h3llf/Arachnid_V2_RevB/ArachnidV2.kicad_sch

## KiCad design ArachnidV2.kicad_sch (2025-01-28)

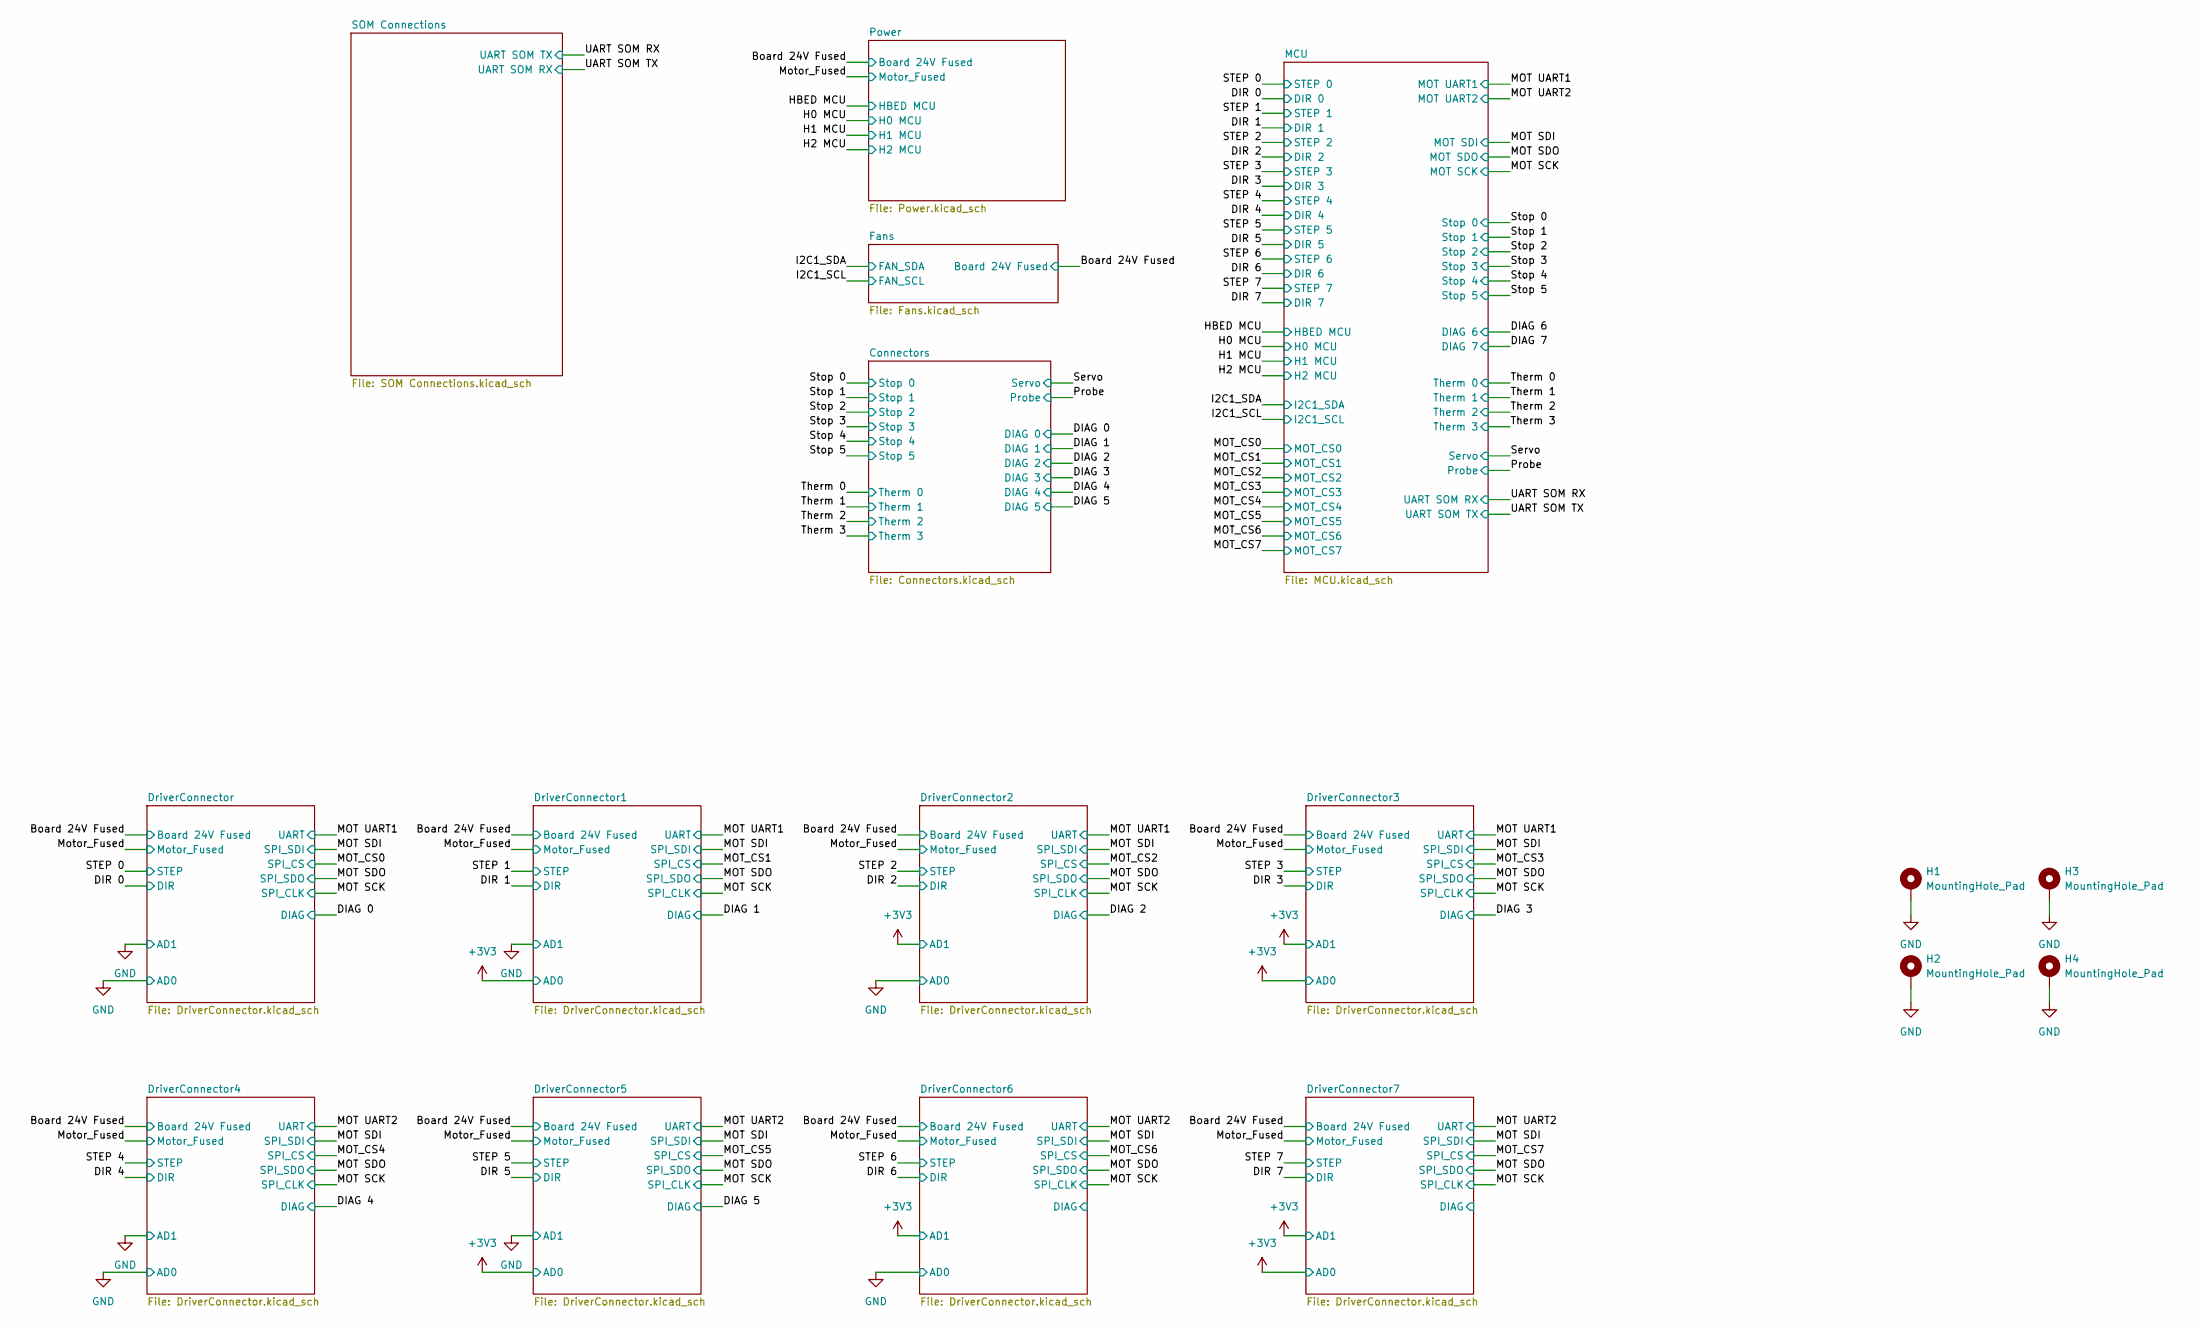
[picture p1: schematic ArachnidV2.kicad_sch]

Parts:
H1, H2, H3, H4: MountingHole_Pad; MountingHole_3.2mm_M3_Pad_TopBottom

Connections:
GND: H1.1, H2.1, H3.1, H4.1
