h3llf/Arachnid_V2_RevB/Connectors.kicad_sch

## KiCad design Connectors.kicad_sch (2025-01-28)

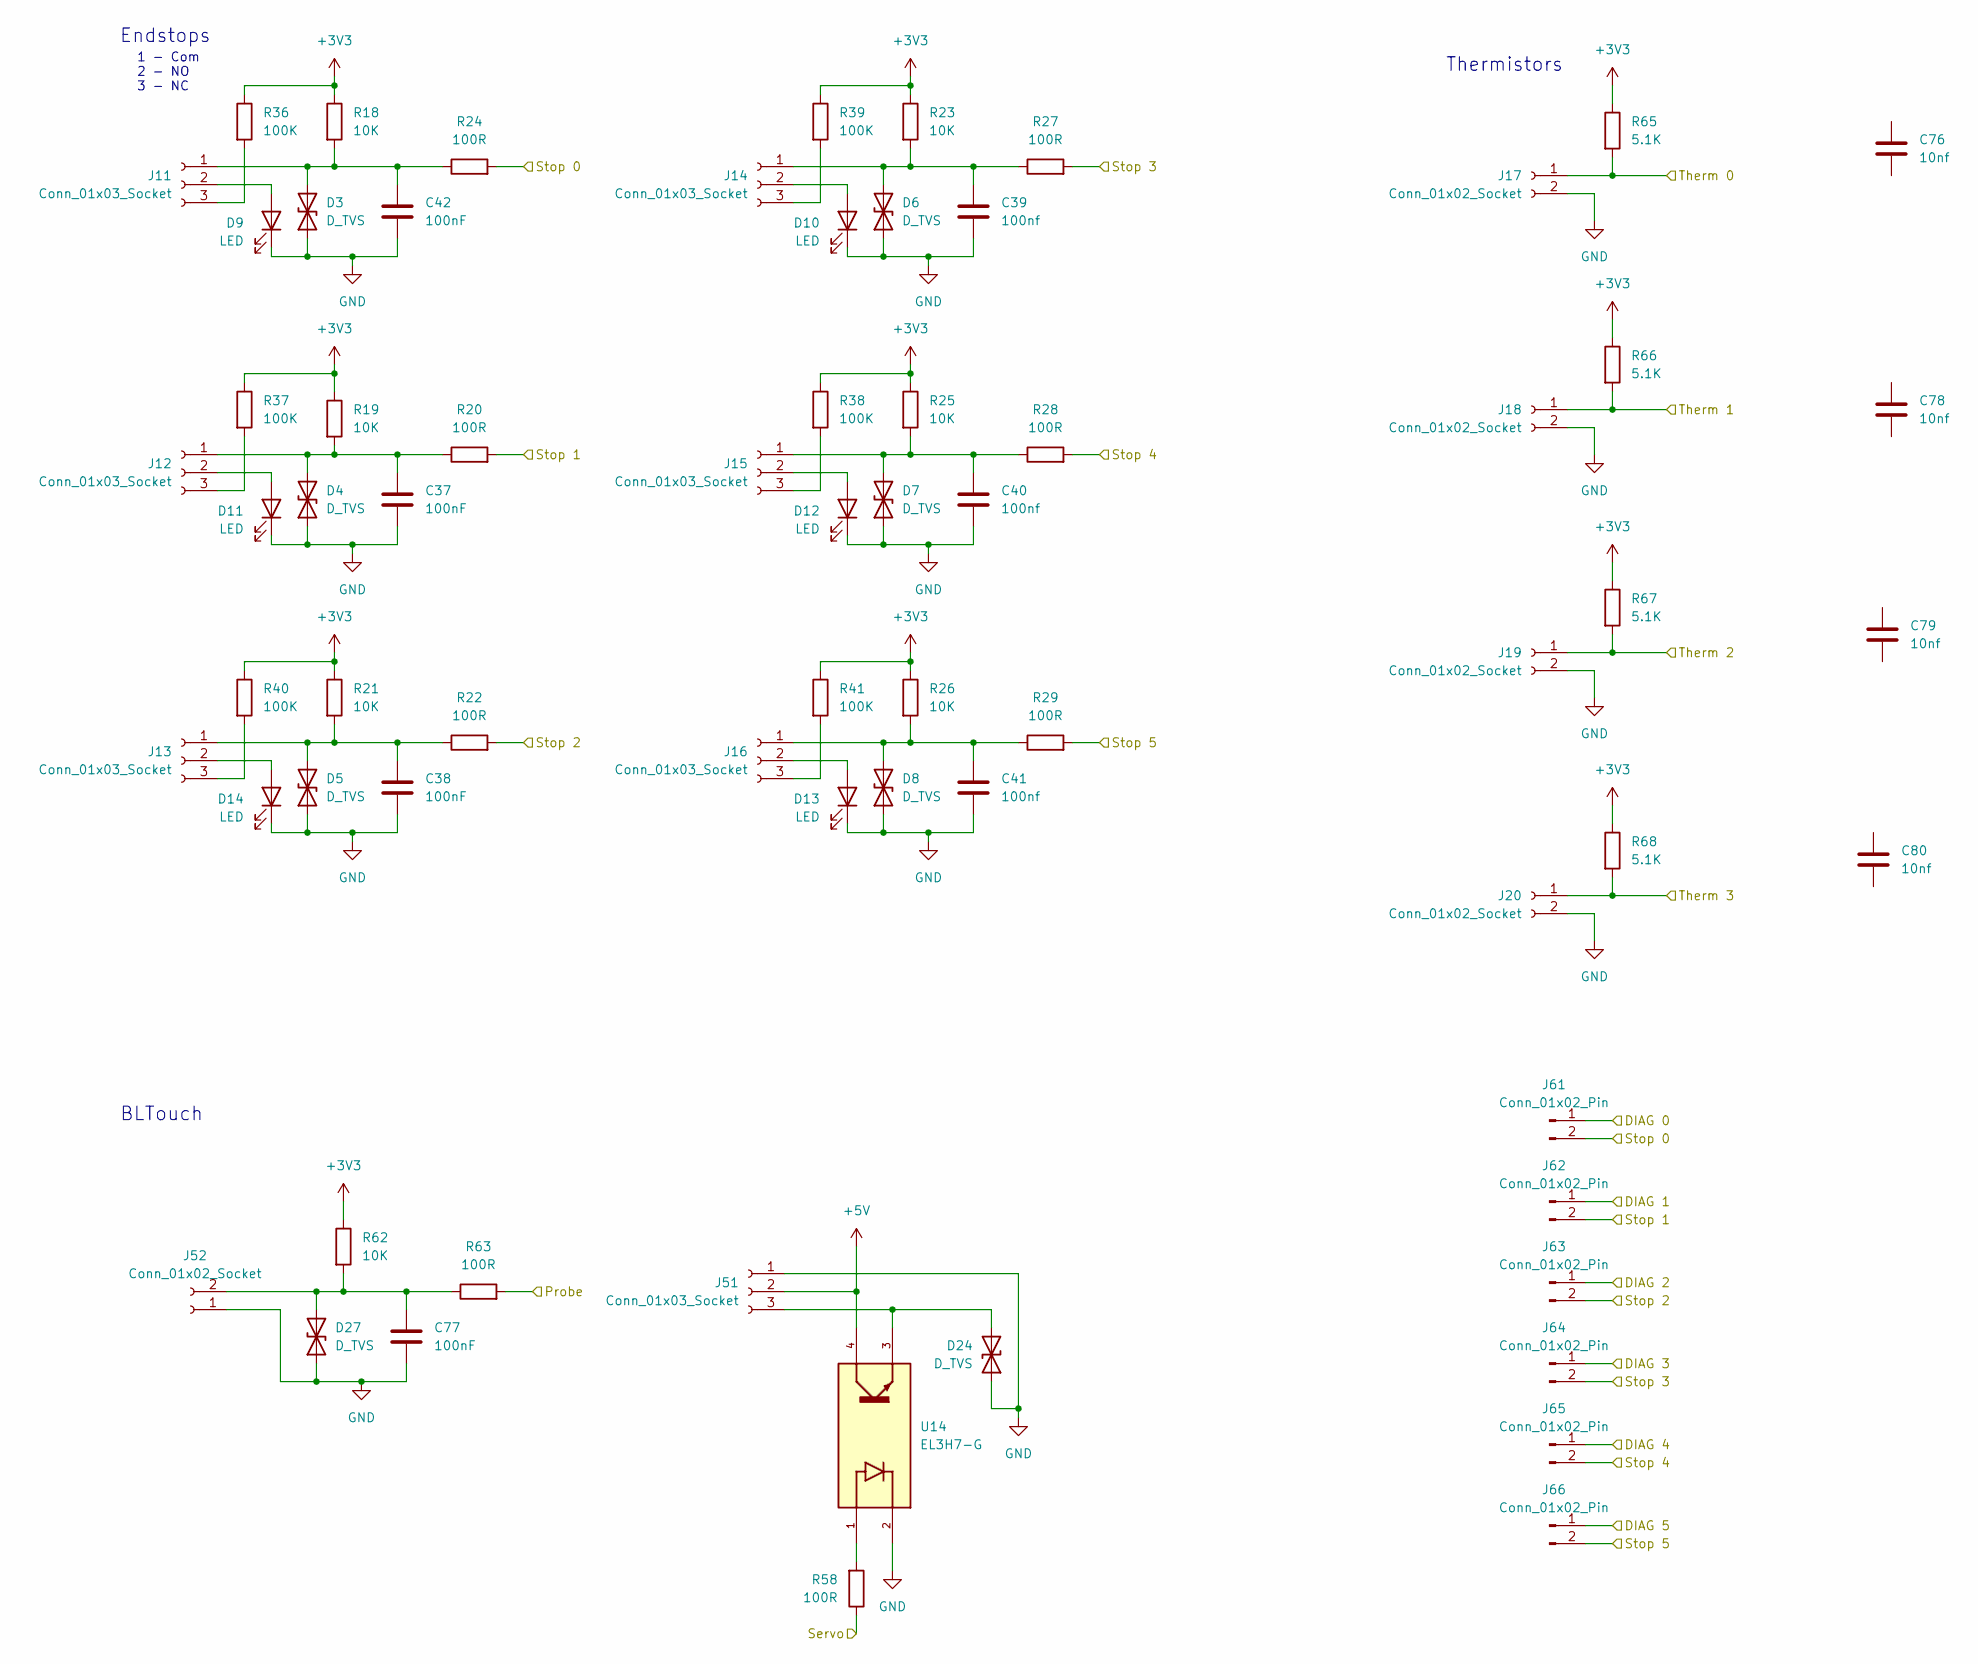
[picture p2: schematic Connectors.kicad_sch]

Parts:
C37, C38, C42, C77: 100nF; C_0603_1608Metric
C39, C40, C41: 100nf; C_0603_1608Metric
C76, C78, C79, C80: 10nf; C_0603_1608Metric
D3, D4, D5, D6, D7, D8, D27: D_TVS; D_SOD-882
D9, D10, D11, D12, D13, D14: LED; LED_0603_1608Metric
D24: D_TVS; D_SOD-323
J11, J12, J13, J14, J15, J16, J51: Conn_01x03_Socket; JST_XH_B3B-XH-A_1x03_P2.50mm_Vertical
J17, J18, J19, J20, J52: Conn_01x02_Socket; JST_XH_B2B-XH-A_1x02_P2.50mm_Vertical
J61, J62, J63, J64, J65, J66: Conn_01x02_Pin; PinHeader_1x02_P2.54mm_Vertical
R18, R19, R21, R23, R25, R26, R62: 10K; R_0603_1608Metric
R20, R22, R24, R27, R28, R29, R58, R63: 100R; R_0603_1608Metric
R36, R37, R38, R39, R40, R41: 100K; R_0603_1608Metric
R65, R66, R67, R68: 5.1K; R_0603_1608Metric
U14: EL3H7-G; SOIC127P700X200-4N; PARTREV 7

Connections:
+3V3: R18.1, R19.1, R21.1, R23.1, R25.1, R26.1, R36.1, R37.1, R38.1, R39.1, R40.1, R41.1, R62.1, R65.1, R66.1, R67.1, R68.1
+5V: J51.2, U14.4
DIAG 0: J61.1
DIAG 1: J62.1
DIAG 2: J63.1
DIAG 3: J64.1
DIAG 4: J65.1
DIAG 5: J66.1
GND: C37.2, C38.2, C39.2, C40.2, C41.2, C42.2, C77.2, D3.1 (A1), D4.1 (A1), D5.1 (A1), D6.1 (A1), D7.1 (A1), D8.1 (A1), D9.1 (K), D10.1 (K), D11.1 (K), D12.1 (K), D13.1 (K), D14.1 (K), D24.1 (A1), D27.1 (A1), J17.2, J18.2, J19.2, J20.2, J51.1, J52.1, U14.2
unnamed: C37.1, D4.2 (A2), J12.1, R19.2, R20.1
unnamed: C38.1, D5.2 (A2), J13.1, R21.2, R22.1
unnamed: C39.1, D6.2 (A2), J14.1, R23.2, R27.1
unnamed: C40.1, D7.2 (A2), J15.1, R25.2, R28.1
unnamed: C41.1, D8.2 (A2), J16.1, R26.2, R29.1
unnamed: C42.1, D3.2 (A2), J11.1, R18.2, R24.1
unnamed: C77.1, D27.2 (A2), J52.2, R62.2, R63.1
unnamed: D9.2 (A), J11.2
unnamed: D10.2 (A), J14.2
unnamed: D11.2 (A), J12.2
unnamed: D12.2 (A), J15.2
unnamed: D13.2 (A), J16.2
unnamed: D14.2 (A), J13.2
unnamed: D24.2 (A2), J51.3, U14.3
unnamed: J11.3, R36.2
unnamed: J12.3, R37.2
unnamed: J13.3, R40.2
unnamed: J14.3, R39.2
unnamed: J15.3, R38.2
unnamed: J16.3, R41.2
unnamed: R58.2, U14.1
Probe: R63.2
Servo: R58.1
Stop 0: J61.2, R24.2
Stop 1: J62.2, R20.2
Stop 2: J63.2, R22.2
Stop 3: J64.2, R27.2
Stop 4: J65.2, R28.2
Stop 5: J66.2, R29.2
Therm 0: J17.1, R65.2
Therm 1: J18.1, R66.2
Therm 2: J19.1, R67.2
Therm 3: J20.1, R68.2

Notes on the sheet:
1 - Com 2 - NO 3 - NC
Endstops
BLTouch
Thermistors
