h3llf/Arachnid_V2_RevB/DriverConnector.kicad_sch

## KiCad design DriverConnector.kicad_sch (2025-01-28)

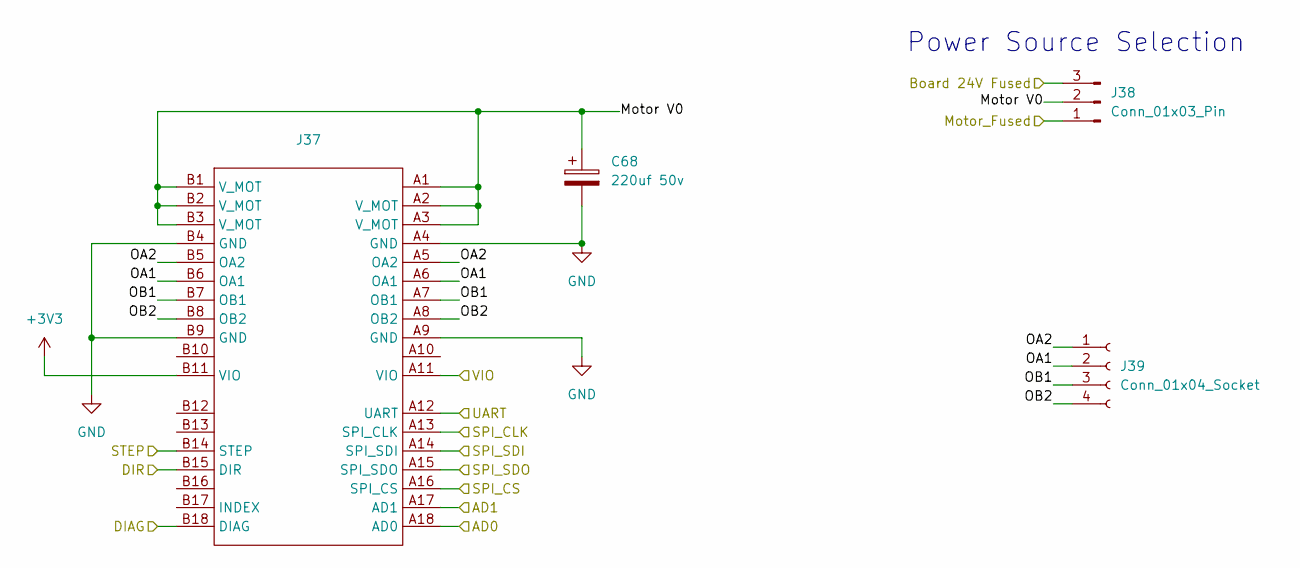
[picture p3: schematic DriverConnector.kicad_sch]

Parts:
C68: 220uf 50v; CP_Elec_10x10
J37: UMAX_3183-10200P1T_PCIEx1
J38: Conn_01x03_Pin; PinHeader_1x03_P2.54mm_Vertical
J39: Conn_01x04_Socket; JST_XH_B4B-XH-A_1x04_P2.50mm_Vertical

Connections:
+3V3: J37.B11 (VIO)
AD0: J37.A18 (AD0)
AD1: J37.A17 (AD1)
Board 24V Fused: J38.3
DIAG: J37.B18 (DIAG)
DIR: J37.B15 (DIR)
GND: C68.2, J37.A4 (GND), J37.A9 (GND), J37.B4 (GND), J37.B9 (GND)
Motor V0: C68.1, J37.A1, J37.A2 (V_MOT), J37.A3 (V_MOT), J37.B1 (V_MOT), J37.B2 (V_MOT), J37.B3 (V_MOT), J38.2
Motor_Fused: J38.1
OA1: J37.A6 (OA1), J37.B6 (OA1), J39.2
OA2: J37.A5 (OA2), J37.B5 (OA2), J39.1
OB1: J37.A7 (OB1), J37.B7 (OB1), J39.3
OB2: J37.A8 (OB2), J37.B8 (OB2), J39.4
SPI_CLK: J37.A13 (SPI_CLK)
SPI_CS: J37.A16 (SPI_CS)
SPI_SDI: J37.A14 (SPI_SDI)
SPI_SDO: J37.A15 (SPI_SDO)
STEP: J37.B14 (STEP)
UART: J37.A12 (UART)
VIO: J37.A11 (VIO)

Notes on the sheet:
Power Source Selection
