h3llf/Arachnid_V2_RevB/Fans.kicad_sch

## KiCad design Fans.kicad_sch (2025-01-28)

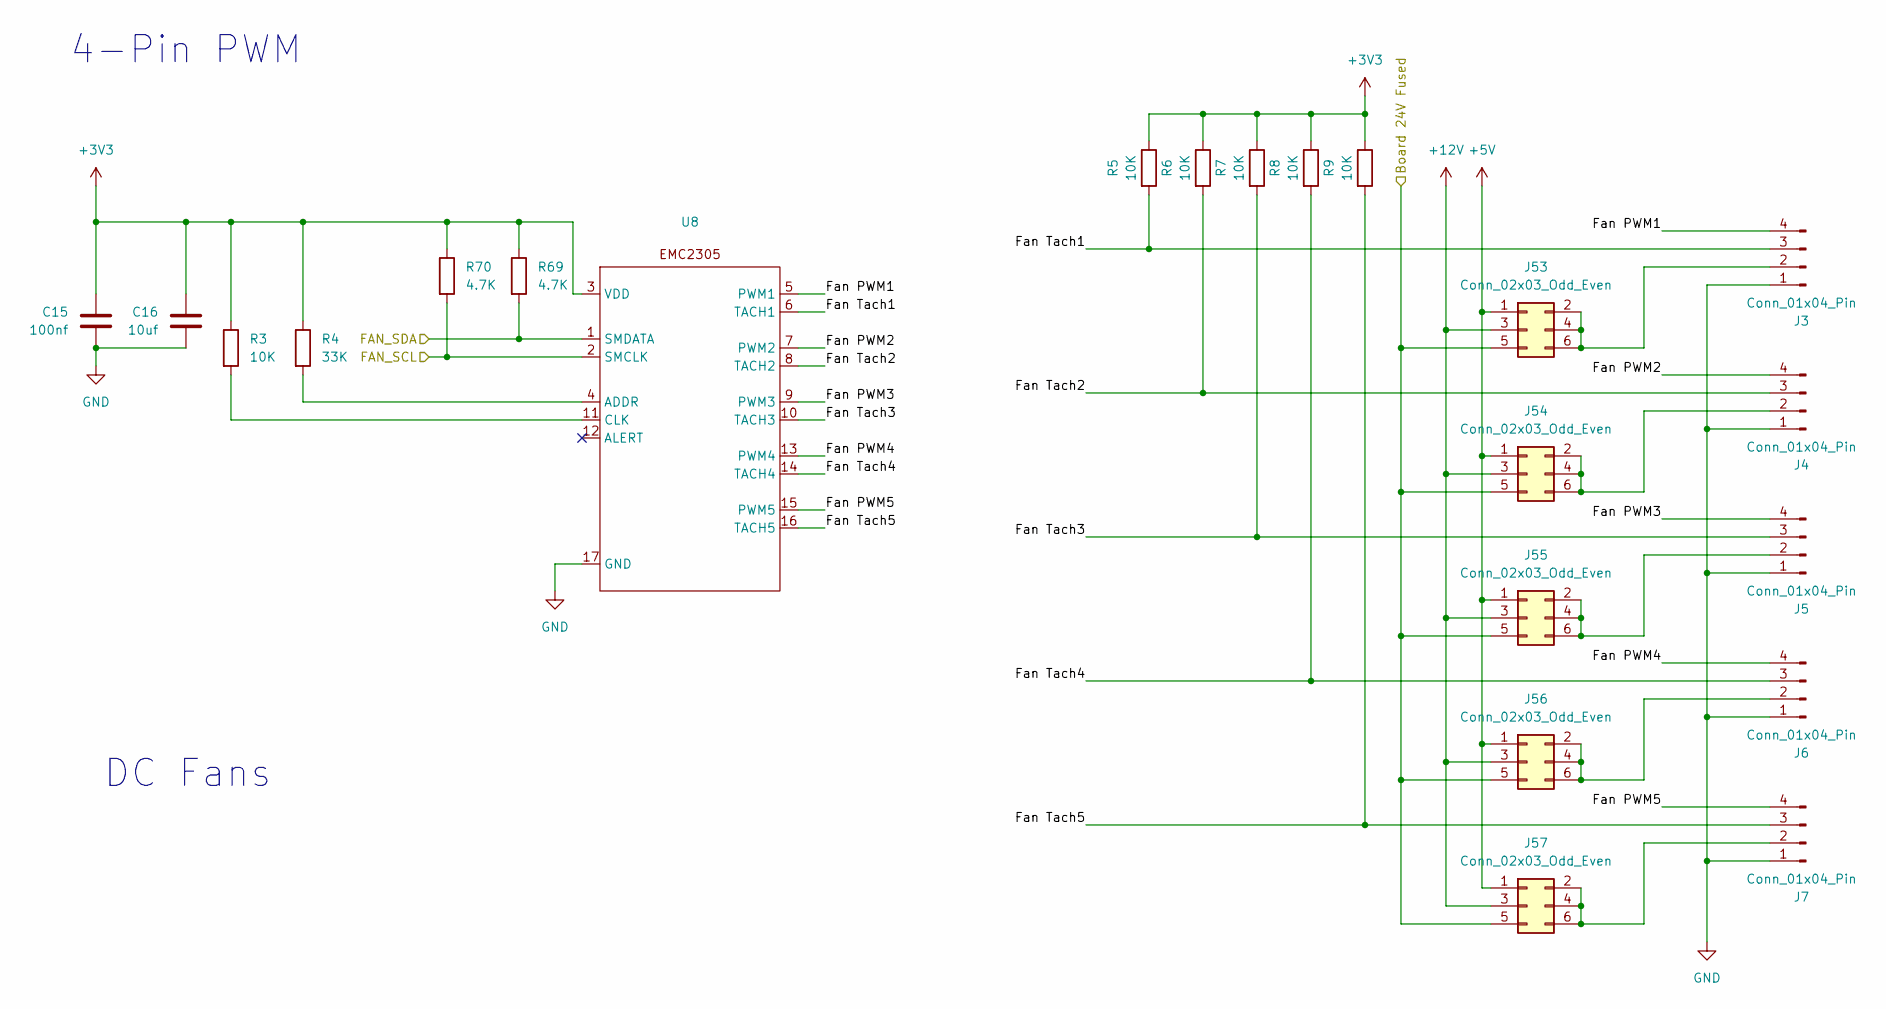
[picture p4: schematic Fans.kicad_sch]

Parts:
C15: 100nf; C_0603_1608Metric
C16: 10uf; C_0603_1608Metric
J3, J4, J5, J6, J7: Conn_01x04_Pin; FanPinHeader_1x04_P2.54mm_Vertical
J53, J54, J55, J56, J57: Conn_02x03_Odd_Even; PinHeader_2x03_P2.54mm_Vertical
R3: 10K; R_0603_1608Metric
R4: 33K; R_0603_1608Metric
R5, R6, R7, R8, R9: 10K; R_0402_1005Metric_Pad0.72x0.64mm_HandSolder
R69, R70: 4.7K; R_0603_1608Metric
U8: QFN-16-1EP_4x4mm_P0.65mm_EP2.1x2.1mm

Connections:
+3V3: C15.1, C16.1, R3.1, R4.1, R5.1, R6.1, R7.1, R8.1, R9.1, R69.1, R70.1, U8.3 (VDD)
+5V: J53.1, J54.1, J55.1, J56.1, J57.1
+12V: J53.3, J54.3, J55.3, J56.3, J57.3
Board 24V Fused: J53.5, J54.5, J55.5, J56.5, J57.5
FAN_SCL: R70.2, U8.2 (SMCLK)
FAN_SDA: R69.2, U8.1 (SMDATA)
Fan PWM1: J3.4, U8.5 (PWM1)
Fan PWM2: J4.4, U8.7 (PWM2)
Fan PWM3: J5.4, U8.9 (PWM3)
Fan PWM4: J6.4, U8.13 (PWM4)
Fan PWM5: J7.4, U8.15 (PWM5)
Fan Tach1: J3.3, R5.2, U8.6 (TACH1)
Fan Tach2: J4.3, R6.2, U8.8 (TACH2)
Fan Tach3: J5.3, R7.2, U8.10 (TACH3)
Fan Tach4: J6.3, R8.2, U8.14 (TACH4)
Fan Tach5: J7.3, R9.2, U8.16 (TACH5)
GND: C15.2, C16.2, J3.1, J4.1, J5.1, J6.1, J7.1, U8.17 (GND)
unnamed: J3.2, J53.2, J53.4, J53.6
unnamed: J4.2, J54.2, J54.4, J54.6
unnamed: J5.2, J55.2, J55.4, J55.6
unnamed: J6.2, J56.2, J56.4, J56.6
unnamed: J7.2, J57.2, J57.4, J57.6
unnamed: R3.2, U8.11 (CLK)
unnamed: R4.2, U8.4 (ADDR)

Notes on the sheet:
DC Fans
4-Pin PWM
