h3llf/Arachnid_V2_RevB/MCU.kicad_sch

## KiCad design MCU.kicad_sch (2025-01-28)

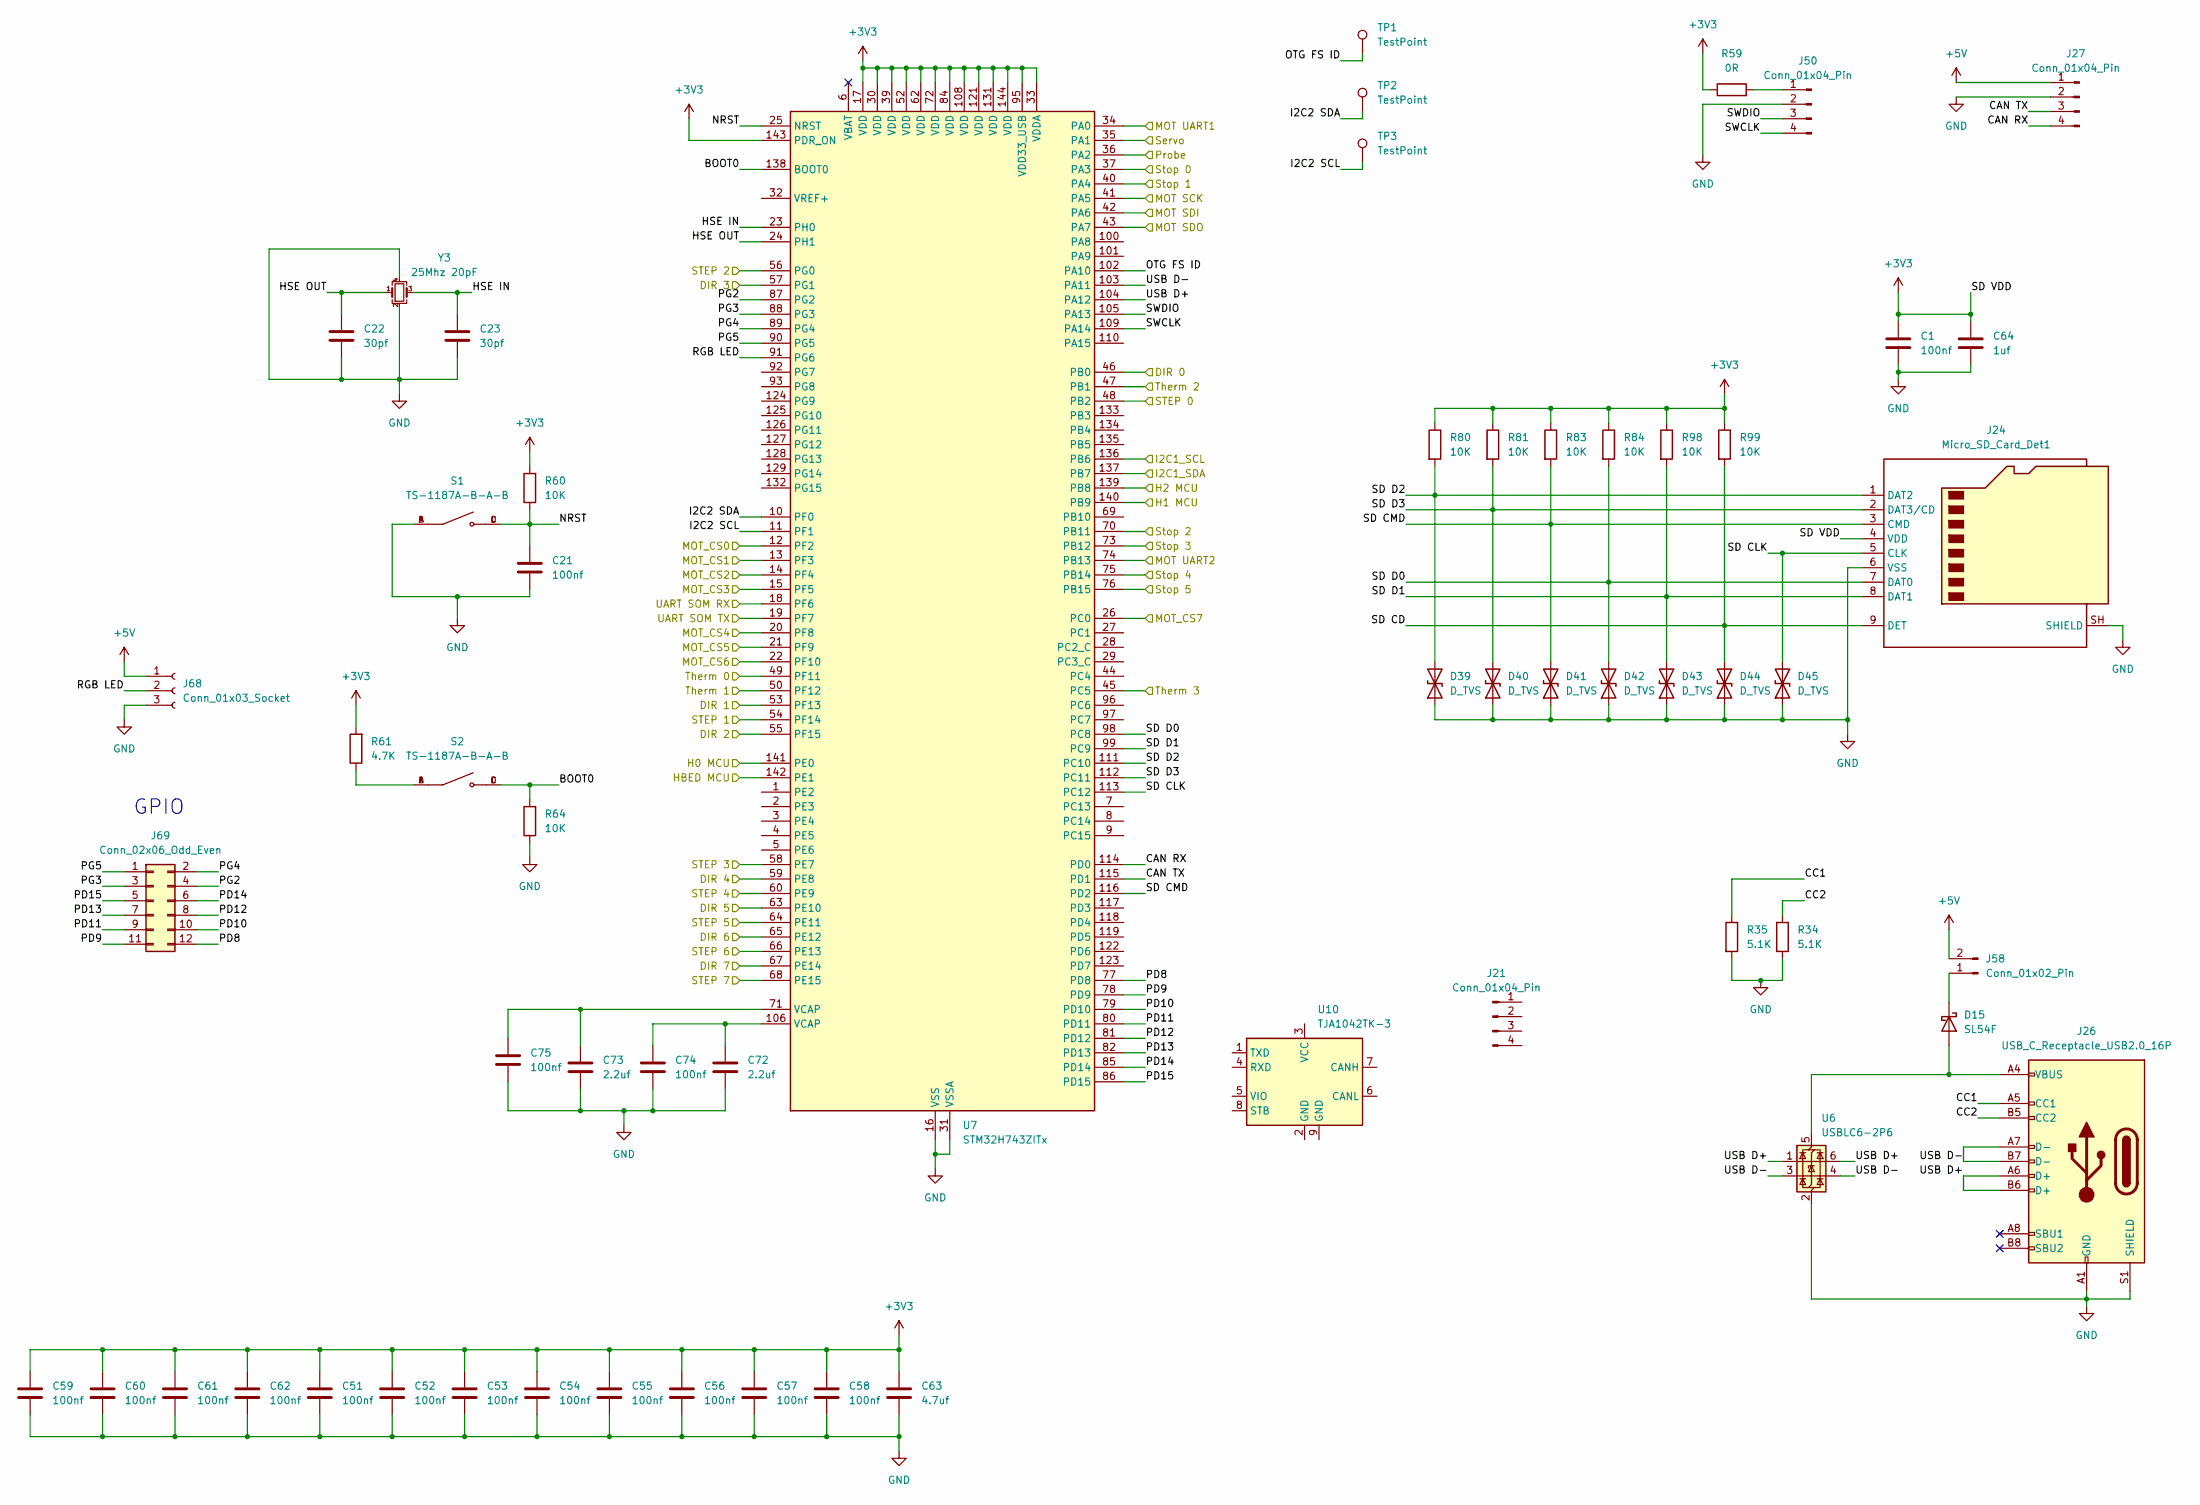
[picture p5: schematic MCU.kicad_sch]

Parts:
C1: 100nf; C_0402_1005Metric
C21, C51, C52, C53, C54, C55, C56, C57, C58, C59, C60, C61, C62, C74, C75: 100nf; C_0603_1608Metric
C22, C23: 30pf; C_0402_1005Metric
C63: 4.7uf; C_0603_1608Metric
C64: 1uf; C_0603_1608Metric
C72, C73: 2.2uf; C_0603_1608Metric
D15: SL54F; D_SMA; LCSC C113939
D39, D40, D41, D42, D43, D44, D45: D_TVS; D_SOD-882
J21: Conn_01x04_Pin; XT30_2+2
J24: Micro_SD_Card_Det1; TF-115
J26: USB_C_Receptacle_USB2.0_16P; USB-C-SMD_TYPE-C-31-M-31
J27, J50: Conn_01x04_Pin; PinHeader_1x04_P2.54mm_Vertical
J58: Conn_01x02_Pin; PinHeader_1x02_P2.54mm_Vertical
J68: Conn_01x03_Socket; PinHeader_1x03_P2.54mm_Vertical
J69: Conn_02x06_Odd_Even; PinHeader_2x06_P2.54mm_Vertical
R34, R35: 5.1K; R_0603_1608Metric
R59: 0R; R_0603_1608Metric
R60, R64: 10K; R_0603_1608Metric
R61: 4.7K; R_0603_1608Metric
R80, R81, R83, R84, R98, R99: 10K; R_0402_1005Metric
S1, S2: TS-1187A-B-A-B; SW_TS-1187A-B-A-B; PARTREV A0
TP1, TP2, TP3: TestPoint; TestPoint_Pad_1.5x1.5mm
U6: USBLC6-2P6; SOT-666
U7: STM32H743ZITx; LQFP-144_20x20mm_P0.5mm
U10: TJA1042TK-3; HVSON-8-1EP_3x3mm_P0.65mm_EP1.6x2.4mm
Y3: 25Mhz 20pF; Crystal_SMD_3225-4Pin_3.2x2.5mm; Part Number X322525MSB4SI; LCSC C13740

Connections:
+3V3: C1.2, C51.1, C52.1, C53.1, C54.1, C55.1, C56.1, C57.1, C58.1, C59.1, C60.1, C61.1, C62.1, C63.1, C64.2, J24.4 (VDD), R59.1, R60.2, R61.2, R80.1, R81.1, R83.1, R84.1, R98.1, R99.1, U7.17 (VDD), U7.30 (VDD), U7.33 (VDDA), U7.39 (VDD), U7.52 (VDD), U7.62 (VDD), U7.72 (VDD), U7.84 (VDD), U7.95 (VDD33_USB), U7.108 (VDD), U7.121 (VDD), U7.131 (VDD), U7.143 (PDR_ON), U7.144 (VDD)
+5V: J27.1, J58.2, J68.1
BOOT0: R64.2, S2.C, S2.D, U7.138 (BOOT0)
CAN RX: J27.4, U7.114 (PD0)
CAN TX: J27.3, U7.115 (PD1)
CC1: J26.A5 (CC1), R35.1
CC2: J26.B5 (CC2), R34.1
DIR 0: U7.46 (PB0)
DIR 1: U7.53 (PF13)
DIR 2: U7.55 (PF15)
DIR 3: U7.57 (PG1)
DIR 4: U7.59 (PE8)
DIR 5: U7.63 (PE10)
DIR 6: U7.65 (PE12)
DIR 7: U7.67 (PE14)
GND: C1.1, C21.2, C22.2, C23.2, C51.2, C52.2, C53.2, C54.2, C55.2, C56.2, C57.2, C58.2, C59.2, C60.2, C61.2, C62.2, C63.2, C64.1, C72.2, C73.2, C74.2, C75.2, D39.1 (A1), D40.1 (A1), D41.1 (A1), D42.1 (A1), D43.1 (A1), D44.1 (A1), D45.1 (A1), J24.6 (VSS), J24.SH (SHIELD), J26.A1 (GND), J26.A12 (GND), J26.B1 (GND), J26.B12 (GND), J26.S1 (SHIELD), J27.2, J50.2, J68.3, R34.2, R35.2, R64.1, S1.A, S1.B, U6.2 (GND), U7.16 (VSS), U7.31 (VSSA), U7.38 (VSS), U7.51 (VSS), U7.61 (VSS), U7.83 (VSS), U7.94 (VSS), U7.107 (VSS), U7.120 (VSS), U7.130 (VSS), Y3.2, Y3.4
H0 MCU: U7.141 (PE0)
H1 MCU: U7.140 (PB9)
H2 MCU: U7.139 (PB8)
HBED MCU: U7.142 (PE1)
HSE IN: C23.1, U7.23 (PH0), Y3.3
HSE OUT: C22.1, U7.24 (PH1), Y3.1
I2C1_SCL: U7.136 (PB6)
I2C1_SDA: U7.137 (PB7)
I2C2 SCL: TP3.1, U7.11 (PF1)
I2C2 SDA: TP2.1, U7.10 (PF0)
MOT SCK: U7.41 (PA5)
MOT SDI: U7.42 (PA6)
MOT SDO: U7.43 (PA7)
MOT UART1: U7.34 (PA0)
MOT UART2: U7.74 (PB13)
MOT_CS0: U7.12 (PF2)
MOT_CS1: U7.13 (PF3)
MOT_CS2: U7.14 (PF4)
MOT_CS3: U7.15 (PF5)
MOT_CS4: U7.20 (PF8)
MOT_CS5: U7.21 (PF9)
MOT_CS6: U7.22 (PF10)
MOT_CS7: U7.26 (PC0)
NRST: C21.1, R60.1, S1.C, S1.D, U7.25 (NRST)
unnamed: C72.1, C74.1, U7.106 (VCAP)
unnamed: C73.1, C75.1, U7.71 (VCAP)
unnamed: D15.1 (K), J58.1
unnamed: D15.2 (A), J26.A4 (VBUS), J26.A9 (VBUS), J26.B4 (VBUS), J26.B9 (VBUS), U6.5 (VBUS)
unnamed: J50.1, R59.2
unnamed: R61.1, S2.A, S2.B
OTG FS ID: TP1.1, U7.102 (PA10)
PD8: J69.12, U7.77 (PD8)
PD9: J69.11, U7.78 (PD9)
PD10: J69.10, U7.79 (PD10)
PD11: J69.9, U7.80 (PD11)
PD12: J69.8, U7.81 (PD12)
PD13: J69.7, U7.82 (PD13)
PD14: J69.6, U7.85 (PD14)
PD15: J69.5, U7.86 (PD15)
PG2: J69.4, U7.87 (PG2)
PG3: J69.3, U7.88 (PG3)
PG4: J69.2, U7.89 (PG4)
PG5: J69.1, U7.90 (PG5)
Probe: U7.36 (PA2)
RGB LED: J68.2, U7.91 (PG6)
SD CD: D44.2 (A2), J24.9 (DET), R99.2
SD CLK: D45.2 (A2), J24.5 (CLK), U7.113 (PC12)
SD CMD: D41.2 (A2), J24.3 (CMD), R83.2, U7.116 (PD2)
SD D0: D42.2 (A2), J24.7 (DAT0), R84.2, U7.98 (PC8)
SD D1: D43.2 (A2), J24.8 (DAT1), R98.2, U7.99 (PC9)
SD D2: D39.2 (A2), J24.1 (DAT2), R80.2, U7.111 (PC10)
SD D3: D40.2 (A2), J24.2 (DAT3/CD), R81.2, U7.112 (PC11)
STEP 0: U7.48 (PB2)
STEP 1: U7.54 (PF14)
STEP 2: U7.56 (PG0)
STEP 3: U7.58 (PE7)
STEP 4: U7.60 (PE9)
STEP 5: U7.64 (PE11)
STEP 6: U7.66 (PE13)
STEP 7: U7.68 (PE15)
SWCLK: J50.4, U7.109 (PA14)
SWDIO: J50.3, U7.105 (PA13)
Servo: U7.35 (PA1)
Stop 0: U7.37 (PA3)
Stop 1: U7.40 (PA4)
Stop 2: U7.70 (PB11)
Stop 3: U7.73 (PB12)
Stop 4: U7.75 (PB14)
Stop 5: U7.76 (PB15)
Therm 0: U7.49 (PF11)
Therm 1: U7.50 (PF12)
Therm 2: U7.47 (PB1)
Therm 3: U7.45 (PC5)
UART SOM RX: U7.18 (PF6)
UART SOM TX: U7.19 (PF7)
USB D+: J26.A6 (D+), J26.B6 (D+), U6.1 (I/O1), U6.6 (I/O1), U7.104 (PA12)
USB D-: J26.A7 (D-), J26.B7 (D-), U6.3 (I/O2), U6.4 (I/O2), U7.103 (PA11)

Notes on the sheet:
GPIO
