h3llf/Arachnid_V2_RevB/Power converters.kicad_sch

## KiCad design Power converters.kicad_sch (2025-01-28)

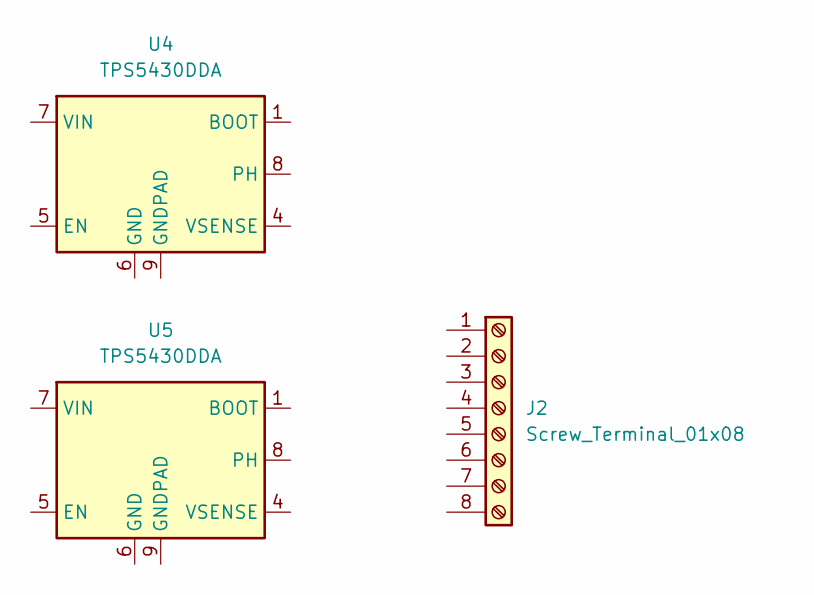
[picture p6: schematic Power converters.kicad_sch]

Parts:
J2: Screw_Terminal_01x08; TerminalBlock_RND_205-00029_1x08_P10.00mm_Horizontal
U4, U5: TPS5430DDA; TI_SO-PowerPAD-8_ThermalVias
