h3llf/Arachnid_V2_RevB/Power.kicad_sch

## KiCad design Power.kicad_sch (2025-01-28)

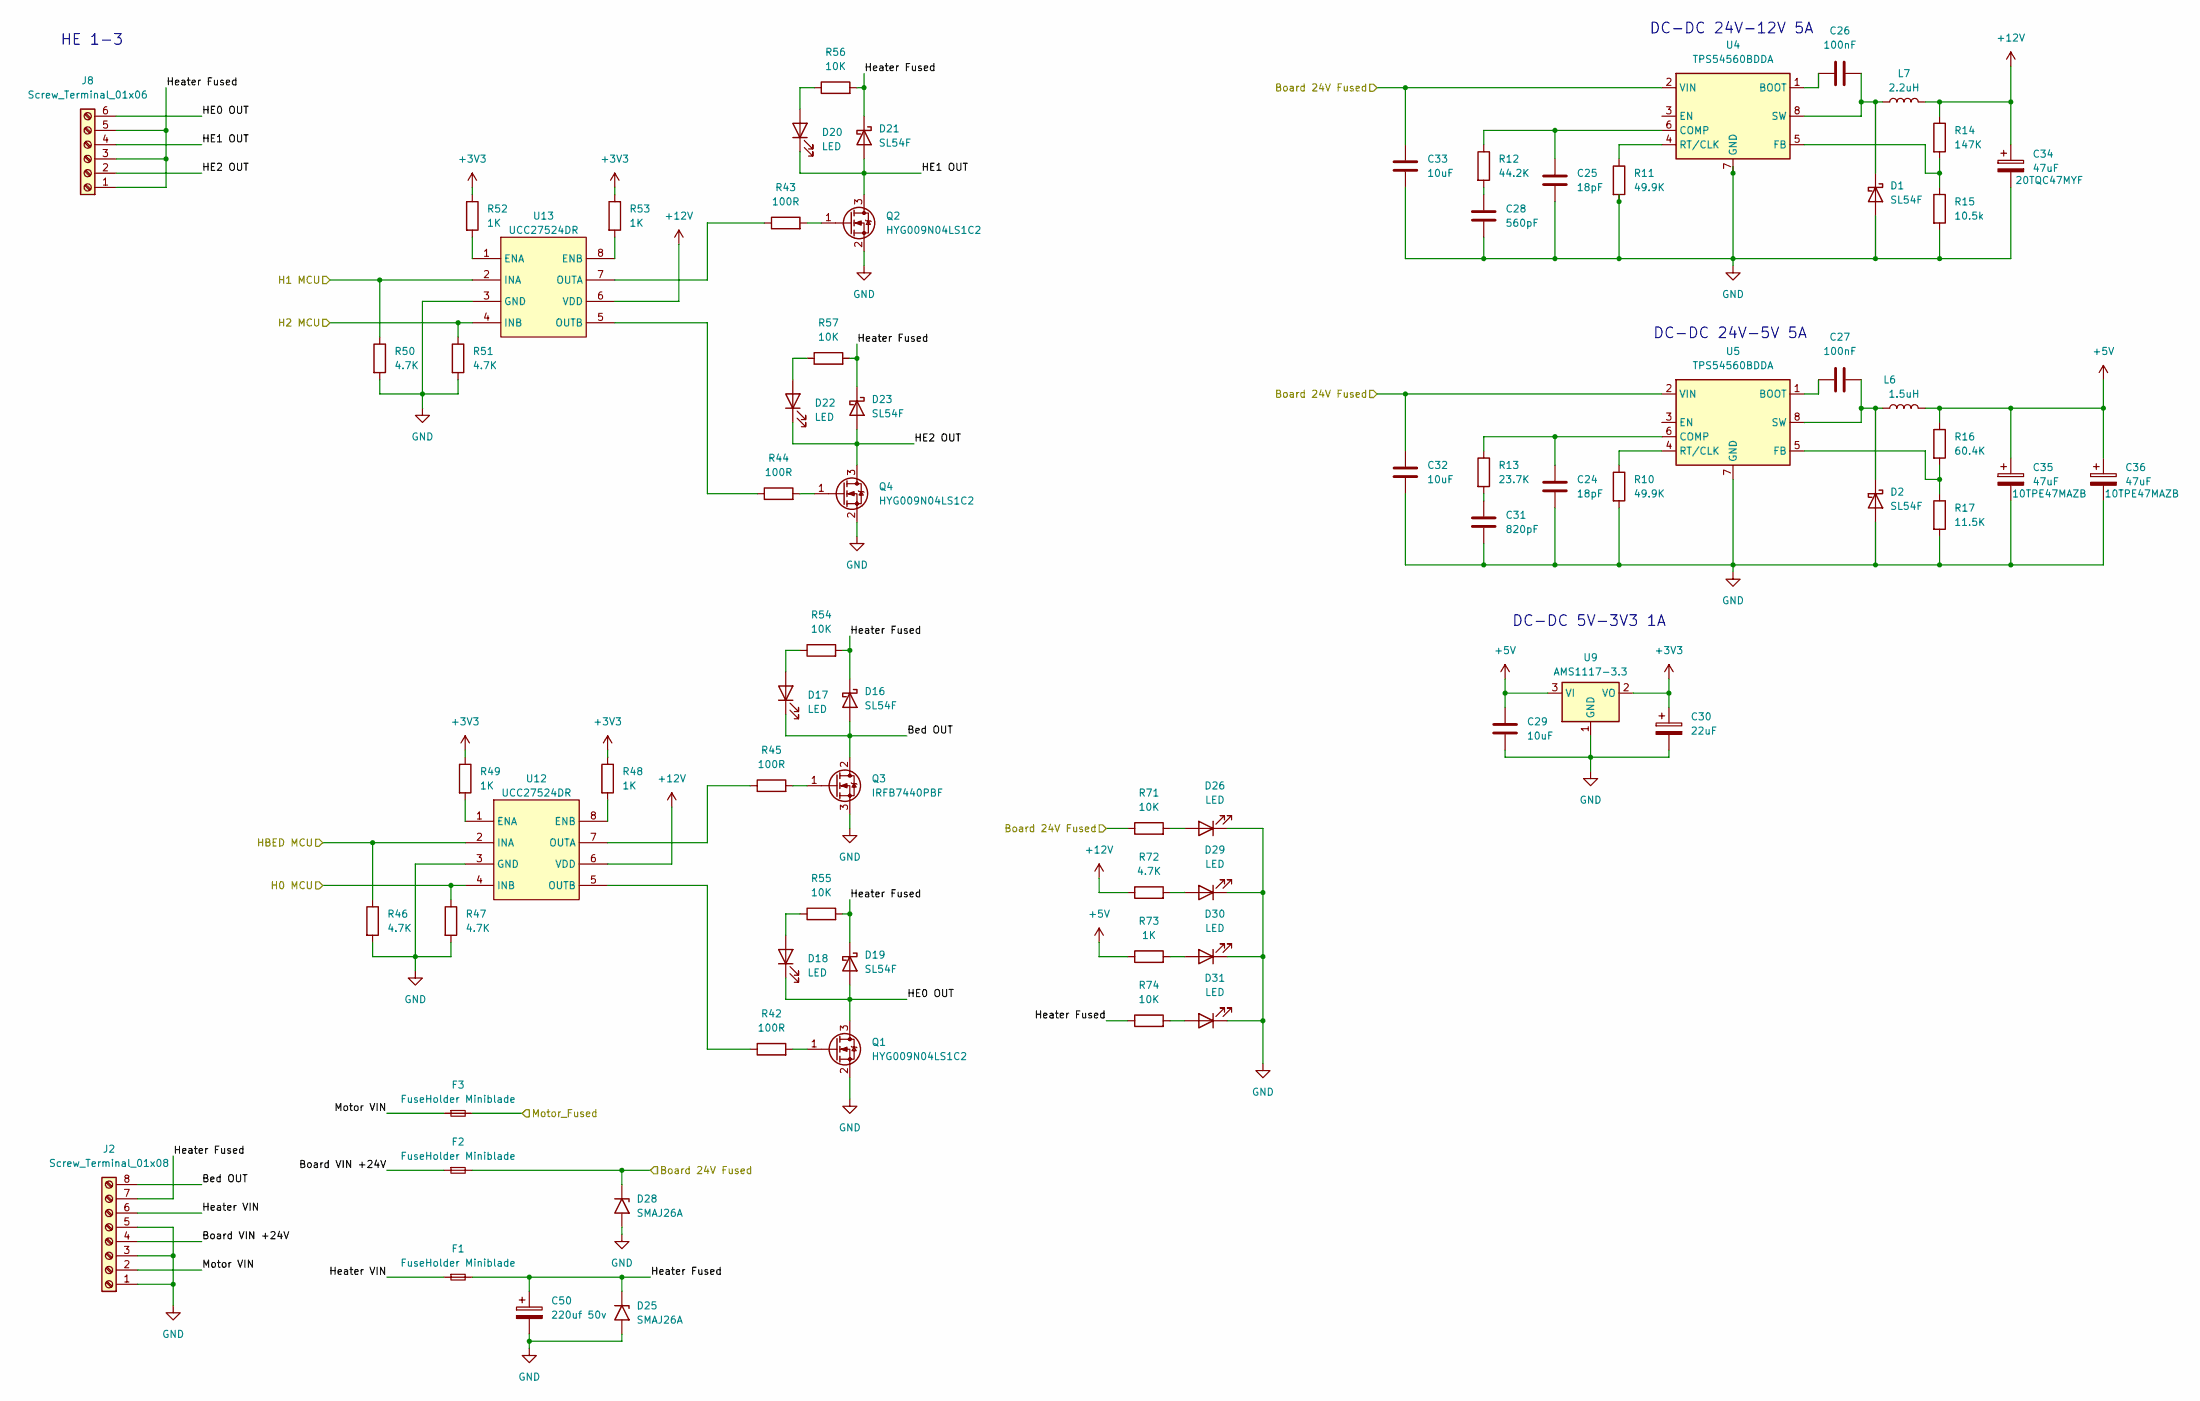
[picture p7: schematic Power.kicad_sch]

Parts:
C24, C25: 18pF; C_0603_1608Metric; LCSC C107040
C26, C27: 100nF; C_0603_1608Metric
C28: 560pF; C_0603_1608Metric; LCSC C107054
C29: 10uF; C_1206_3216Metric
C30: 22uF; CP_EIA-3216-18_Kemet-A
C31: 820pF; C_0603_1608Metric; LCSC C107057
C32, C33: 10uF; C_1206_3216Metric; LCSC C13585
C34: 47uF; CP_EIA-7343-31_Kemet-D; LCSC C147771
C35, C36: 47uF; CP_EIA-3528-21_Kemet-B; LCSC C147768
C50: 220uf 50v; CP_Elec_10x10
D1, D2, D16, D19, D21, D23: SL54F; D_SMA; LCSC C113939
D17, D18, D20, D22: LED; LED_0603_1608Metric; LCSC C965799
D25, D28: SMAJ26A; D_SMA
D26, D29, D30, D31: LED; LED_0603_1608Metric; LCSC C965807
F1, F2, F3: FuseHolder Miniblade; Fuseholder_Blade_Mini_Keystone_3568
J2: Screw_Terminal_01x08; TerminalBlock_01x08_P9.5mm
J8: Screw_Terminal_01x06; TerminalBlock_Phoenix_MKDS-1,5-6_1x06_P5.00mm_Horizontal
L6: 1.5uH; L_Sunlord_MWSA0503S
L7: 2.2uH; L_Sunlord_MWSA0503S
Q1, Q2, Q4: HYG009N04LS1C2; PowerPAK_SO-8_Single
Q3: IRFB7440PBF; TO-220-3_Vertical
R10, R11: 49.9K; R_0603_1608Metric; LCSC C23184
R12: 44.2K; R_0603_1608Metric; LCSC C23056
R13: 23.7K; R_0603_1608Metric; LCSC C22912
R14: 147K; R_0603_1608Metric; LCSC C2998060
R15: 10.5k; R_0603_1608Metric; LCSC C2933127
R16: 60.4K; R_0603_1608Metric; LCSC C23089
R17: 11.5K; R_0603_1608Metric; LCSC C2930057
R42, R43, R44, R45: 100R; R_0603_1608Metric
R46, R47, R50, R51: 4.7K; R_0603_1608Metric
R48, R49, R52, R53: 1K; R_0603_1608Metric
R54, R55, R56, R57: 10K; R_0603_1608Metric
R71, R74: 10K; R_0603_1608Metric_Pad0.98x0.95mm_HandSolder
R72: 4.7K; R_0603_1608Metric_Pad0.98x0.95mm_HandSolder
R73: 1K; R_0603_1608Metric_Pad0.98x0.95mm_HandSolder
U4, U5: TPS54560BDDA; Texas_R-PDSO-G8_EP2.95x4.9mm_Mask2.4x3.1mm_ThermalVias; LCSC C31966
U9: AMS1117-3.3; SOT-223-3_TabPin2
U12: UCC27524DR; SOIC-8_3.9x4.9mm_P1.27mm
U13: UCC27524DR; SOIC-8_3.9x4.9mm_P1.27mm; LCSC C465729

Connections:
+3V3: C30.1, R48.1, R49.1, R52.1, R53.1, U9.2 (VO)
+5V: C29.1, C35.1, C36.1, L6.2, R16.1, R73.1, U9.3 (VI)
+12V: C34.1, L7.2, R14.1, R72.1, U12.6 (VDD), U13.6 (VDD)
Bed OUT: D16.2 (A), D17.1 (K), J2.8, Q3.2 (D)
Board 24V Fused: C32.1, C33.1, D28.1 (A1), F2.2, R71.1, U4.2 (VIN), U5.2 (VIN)
Board VIN +24V: F2.1, J2.4
GND: C24.2, C25.2, C28.2, C29.2, C30.2, C31.2, C32.2, C33.2, C34.2, C35.2, C36.2, C50.2, D1.2 (A), D2.2 (A), D25.2 (A2), D26.1 (K), D28.2 (A2), D29.1 (K), D30.1 (K), D31.1 (K), J2.1, J2.3, J2.5, Q1.2 (S), Q2.2 (S), Q3.3 (S), Q4.2 (S), R10.2, R11.2, R15.2, R17.2, R46.2, R47.2, R50.2, R51.2, U4.7 (GND), U4.9 (GND), U5.7 (GND), U5.9 (GND), U9.1 (GND), U12.3 (GND), U13.3 (GND)
H0 MCU: R47.1, U12.4 (INB)
H1 MCU: R50.1, U13.2 (INA)
H2 MCU: R51.1, U13.4 (INB)
HBED MCU: R46.1, U12.2 (INA)
HE0 OUT: D18.1 (K), D19.2 (A), J8.6, Q1.3 (D)
HE1 OUT: D20.1 (K), D21.2 (A), J8.4, Q2.3 (D)
HE2 OUT: D22.1 (K), D23.2 (A), J8.2, Q4.3 (D)
Heater Fused: C50.1, D16.1 (K), D19.1 (K), D21.1 (K), D23.1 (K), D25.1 (A1), F1.2, J2.7, J8.1, J8.3, J8.5, R54.2, R55.2, R56.2, R57.2, R74.1
Heater VIN: F1.1, J2.6
Motor VIN: F3.1, J2.2
Motor_Fused: F3.2
unnamed: C24.1, R13.1, U5.6 (COMP)
unnamed: C25.1, R12.1, U4.6 (COMP)
unnamed: C26.1, U4.1 (BOOT)
unnamed: C26.2, D1.1 (K), L7.1, U4.8 (SW)
unnamed: C27.1, U5.1 (BOOT)
unnamed: C27.2, D2.1 (K), L6.1, U5.8 (SW)
unnamed: C28.1, R12.2
unnamed: C31.1, R13.2
unnamed: D17.2 (A), R54.1
unnamed: D18.2 (A), R55.1
unnamed: D20.2 (A), R56.1
unnamed: D22.2 (A), R57.1
unnamed: D26.2 (A), R71.2
unnamed: D29.2 (A), R72.2
unnamed: D30.2 (A), R73.2
unnamed: D31.2 (A), R74.2
unnamed: Q1.1 (G), R42.2
unnamed: Q2.1 (G), R43.2
unnamed: Q3.1 (G), R45.2
unnamed: Q4.1 (G), R44.2
unnamed: R10.1, U5.4 (RT/CLK)
unnamed: R11.1, U4.4 (RT/CLK)
unnamed: R14.2, R15.1, U4.5 (FB)
unnamed: R16.2, R17.1, U5.5 (FB)
unnamed: R42.1, U12.5 (OUTB)
unnamed: R43.1, U13.7 (OUTA)
unnamed: R44.1, U13.5 (OUTB)
unnamed: R45.1, U12.7 (OUTA)
unnamed: R48.2, U12.8 (ENB)
unnamed: R49.2, U12.1 (ENA)
unnamed: R52.2, U13.1 (ENA)
unnamed: R53.2, U13.8 (ENB)

Notes on the sheet:
HE 1-3
DC-DC 24V-5V 5A
DC-DC 24V-12V 5A
DC-DC 5V-3V3 1A
