h3llf/Arachnid_V2_RevB/SOM Connections.kicad_sch

## KiCad design SOM Connections.kicad_sch (2025-01-28)

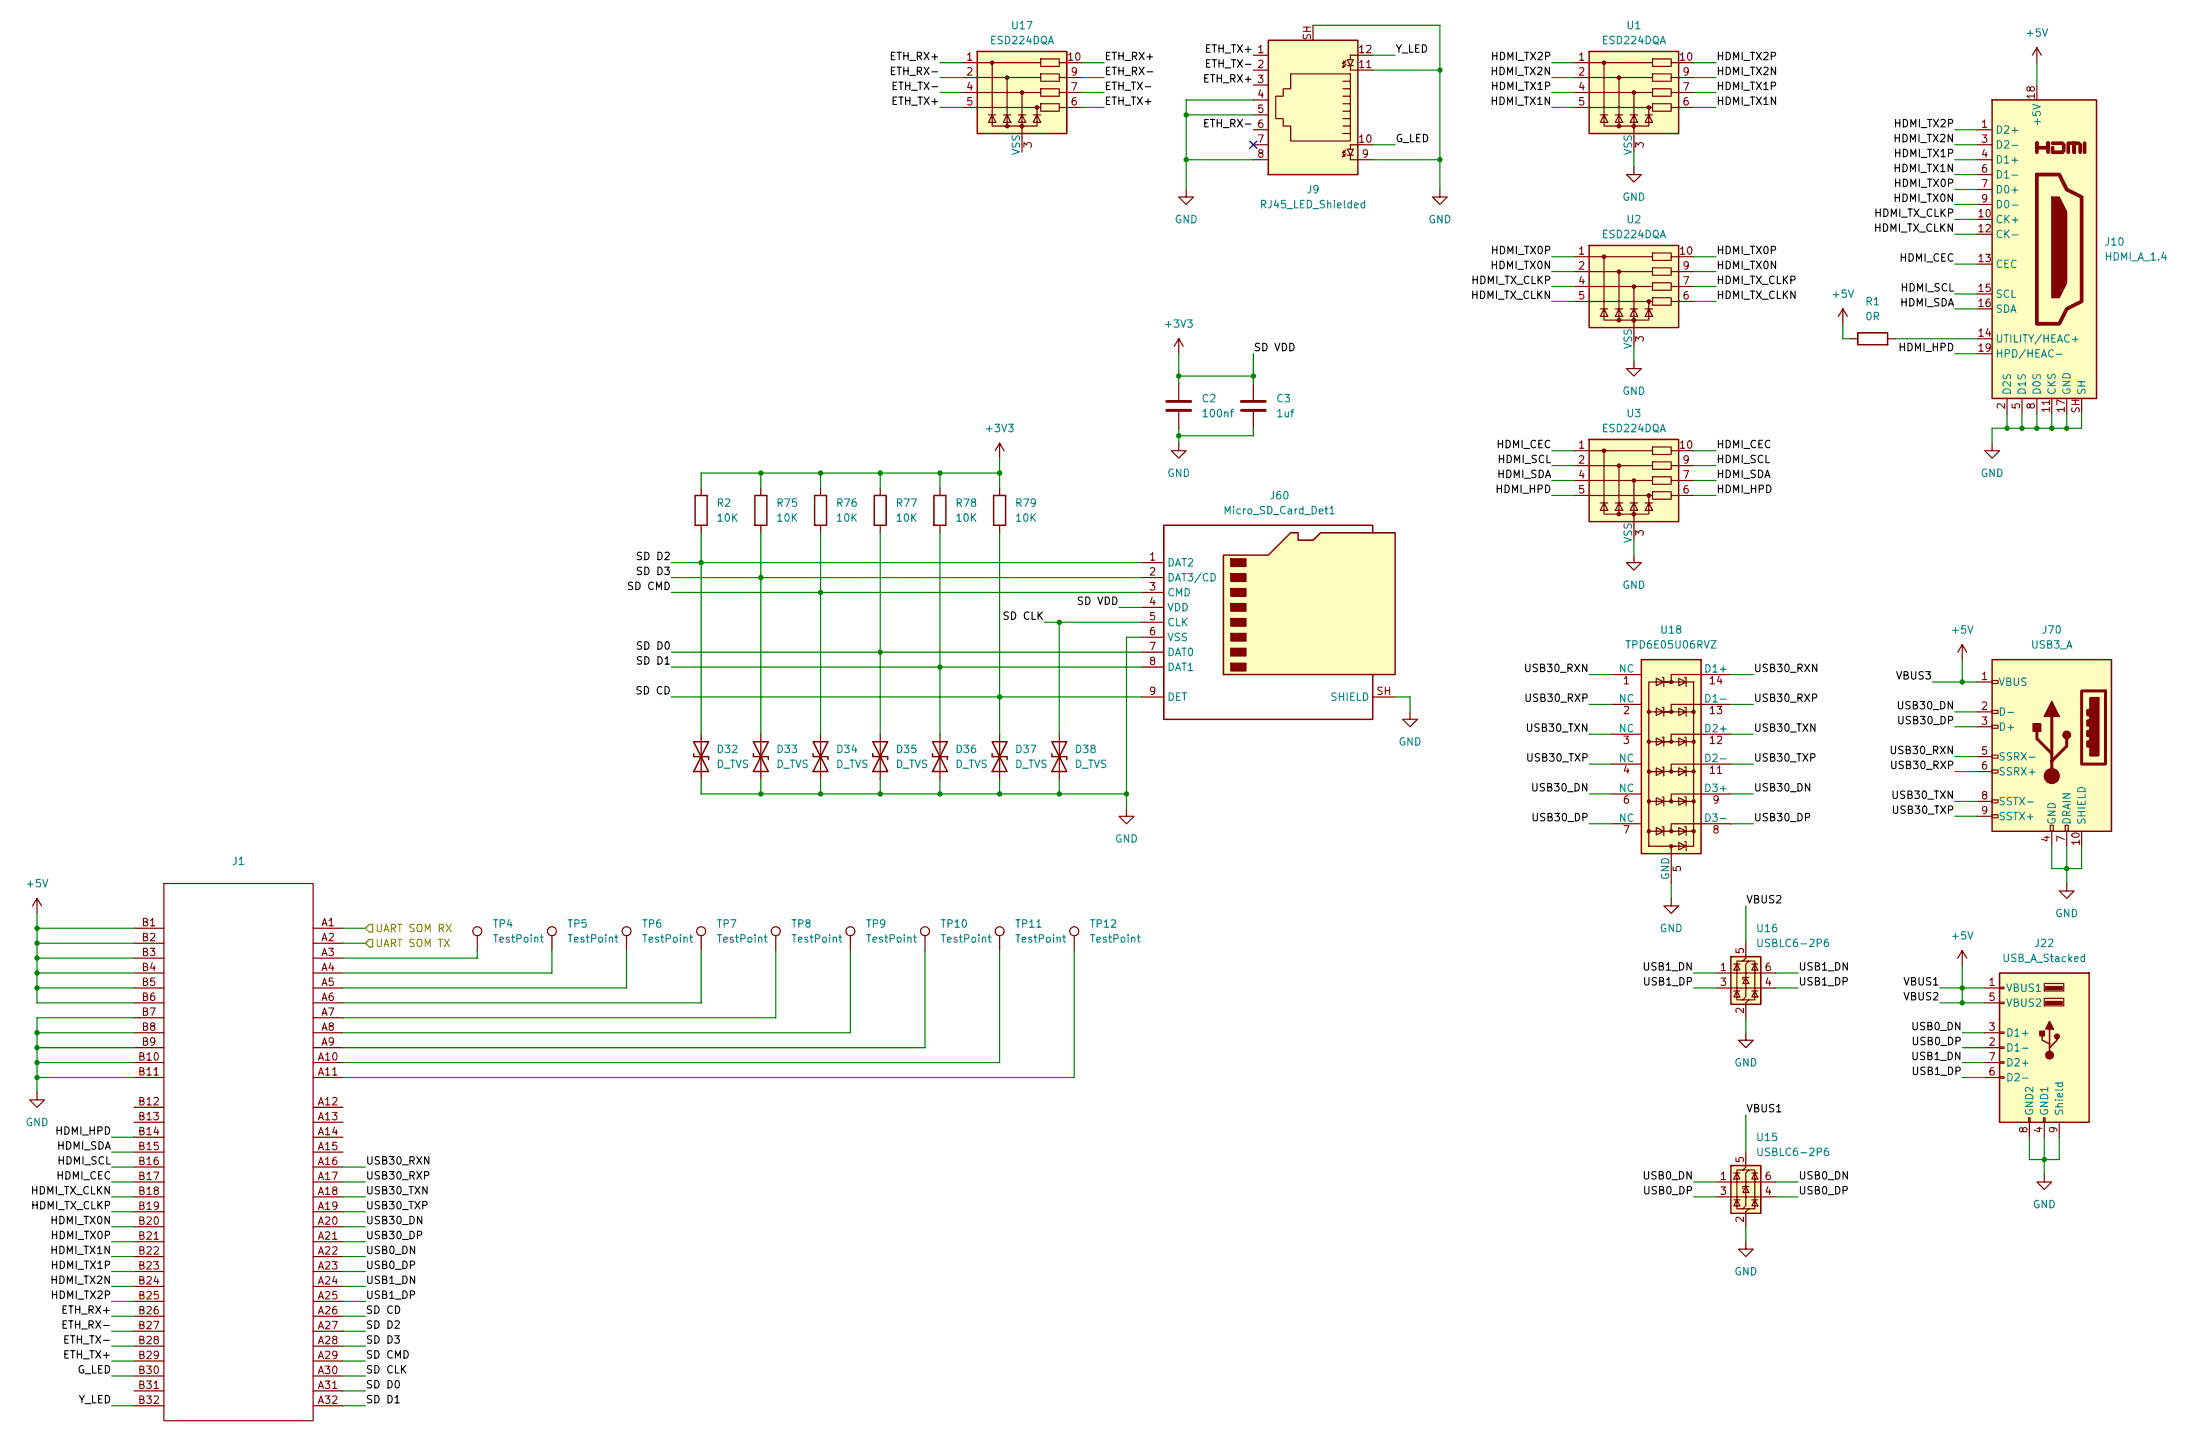
[picture p8: schematic SOM Connections.kicad_sch]

Parts:
C2: 100nf; C_0402_1005Metric
C3: 1uf; C_0603_1608Metric
D32, D33, D34, D35, D36, D37, D38: D_TVS; D_SOD-882
J1: UMAX 3091-10111T
J9: RJ45_LED_Shielded; RJ45_Hanrun_HR911105A_Horizontal
J10: HDMI_A_1.4; HDMI-001S_XUNPU
J22: USB_A_Stacked; SHOU HAN AF SS-JB17.6
J60: Micro_SD_Card_Det1; TF-115
J70: USB3_A; TENSILITY_54-00007
R1: 0R; R_0402_1005Metric
R2, R75, R76, R77, R78, R79: 10K; R_0402_1005Metric
TP4, TP5, TP6, TP7, TP8, TP9, TP10, TP11, TP12: TestPoint; TestPoint_Pad_1.0x1.0mm
U1, U2, U3, U17: ESD224DQA; Diodes_UDFN-10_1.0x2.5mm_P0.5mm
U15, U16: USBLC6-2P6; SOT-666
U18: TPD6E05U06RVZ; Texas_R-PUSON-N14

Connections:
+3V3: C2.2, C3.2, J60.4 (VDD), R2.1, R75.1, R76.1, R77.1, R78.1, R79.1
+5V: J1.B1, J1.B2, J1.B3, J1.B4, J1.B5, J1.B6, J10.18 (+5V), J22.1 (VBUS1), J22.5 (VBUS2), J70.1 (VBUS), R1.1, U15.5 (VBUS), U16.5 (VBUS)
ETH_RX+: J1.B26, J9.3, U17.1, U17.10
ETH_RX-: J1.B27, J9.6, U17.2, U17.9
ETH_TX+: J1.B29, J9.1, U17.5, U17.6
ETH_TX-: J1.B28, J9.2, U17.4, U17.7
GND: C2.1, C3.1, D32.1 (A1), D33.1 (A1), D34.1 (A1), D35.1 (A1), D36.1 (A1), D37.1 (A1), D38.1 (A1), J1.B7, J1.B8, J1.B9, J1.B10, J1.B11, J9.4, J9.5, J9.8, J9.9, J9.11, J9.SH, J10.2 (D2S), J10.5 (D1S), J10.8 (D0S), J10.11 (CKS), J10.17 (GND), J10.SH, J22.4 (GND1), J22.8 (GND2), J22.9 (Shield), J60.6 (VSS), J60.SH (SHIELD), J70.4 (GND), J70.7 (DRAIN), J70.10 (SHIELD), U1.3 (VSS), U1.8 (VSS), U2.3 (VSS), U2.8 (VSS), U3.3 (VSS), U3.8 (VSS), U15.2 (GND), U16.2 (GND), U18.5 (GND), U18.10 (GND)
G_LED: J1.B30, J9.10
HDMI_CEC: J1.B17, J10.13 (CEC), U3.1, U3.10
HDMI_HPD: J1.B14, J10.19 (HPD/HEAC-), U3.5, U3.6
HDMI_SCL: J1.B16, J10.15 (SCL), U3.2, U3.9
HDMI_SDA: J1.B15, J10.16 (SDA), U3.4, U3.7
HDMI_TX0N: J1.B20, J10.9 (D0-), U2.2, U2.9
HDMI_TX0P: J1.B21, J10.7 (D0+), U2.1, U2.10
HDMI_TX1N: J1.B22, J10.6 (D1-), U1.5, U1.6
HDMI_TX1P: J1.B23, J10.4 (D1+), U1.4, U1.7
HDMI_TX2N: J1.B24, J10.3 (D2-), U1.2, U1.9
HDMI_TX2P: J1.B25, J10.1 (D2+), U1.1, U1.10
HDMI_TX_CLKN: J1.B18, J10.12 (CK-), U2.5, U2.6
HDMI_TX_CLKP: J1.B19, J10.10 (CK+), U2.4, U2.7
unnamed: J1.A3, TP4.1
unnamed: J1.A4, TP5.1
unnamed: J1.A5, TP6.1
unnamed: J1.A6, TP7.1
unnamed: J1.A7, TP8.1
unnamed: J1.A8, TP9.1
unnamed: J1.A9, TP10.1
unnamed: J1.A10, TP11.1
unnamed: J1.A11, TP12.1
unnamed: J10.14 (UTILITY/HEAC+), R1.2
unnamed: U17.3 (VSS), U17.8 (VSS)
SD CD: D37.2 (A2), J1.A26, J60.9 (DET), R79.2
SD CLK: D38.2 (A2), J1.A30, J60.5 (CLK)
SD CMD: D34.2 (A2), J1.A29, J60.3 (CMD), R76.2
SD D0: D35.2 (A2), J1.A31, J60.7 (DAT0), R77.2
SD D1: D36.2 (A2), J1.A32, J60.8 (DAT1), R78.2
SD D2: D32.2 (A2), J1.A27, J60.1 (DAT2), R2.2
SD D3: D33.2 (A2), J1.A28, J60.2 (DAT3/CD), R75.2
UART SOM RX: J1.A1
UART SOM TX: J1.A2
USB0_DN: J1.A22, J22.3 (D1+), U15.1 (I/O1), U15.6 (I/O1)
USB0_DP: J1.A23, J22.2 (D1-), U15.3 (I/O2), U15.4 (I/O2)
USB1_DN: J1.A24, J22.7 (D2+), U16.1 (I/O1), U16.6 (I/O1)
USB1_DP: J1.A25, J22.6 (D2-), U16.3 (I/O2), U16.4 (I/O2)
USB30_DN: J1.A20, J70.2 (D-), U18.6 (NC), U18.9 (D3+)
USB30_DP: J1.A21, J70.3 (D+), U18.7 (NC), U18.8 (D3-)
USB30_RXN: J1.A16, J70.5 (SSRX-), U18.1 (NC), U18.14 (D1+)
USB30_RXP: J1.A17, J70.6 (SSRX+), U18.2 (NC), U18.13 (D1-)
USB30_TXN: J1.A18, J70.8 (SSTX-), U18.3 (NC), U18.12 (D2+)
USB30_TXP: J1.A19, J70.9 (SSTX+), U18.4 (NC), U18.11 (D2-)
Y_LED: J1.B32, J9.12
